derangedzebra/Binosaur-Barn/small-unrestrained/readme.md

# Binosaur Barn - Small and Unrestrained V1

This is the upgraded design that is installed at [Mori Point](https://goo.gl/maps/wpSysAgYLS7mhGZ39). It is meant to be attached to a thin metal pole using two pipe clamps. The binoculars inside are meant to be taken and returned, not restrained.

The design can be flipped horizontally if the position of the post needs to be swapped.

Version "b" is designed without the side mount, instead, it uses large pipe clamps for attachment to large fence posts or wire fencing.

### Parts

 * Hinge: https://smile.amazon.com/dp/B08MXQ23G7 (I think Home Depot also carries ones that will work)
 * Screws
   * 8x M3 thread 10mm long
   * 4x M3 thread nut (tooth-lock washer incorporated)
   * 4x #4 screws, either for sheet metal or wood
 * Pipe Clamps (number and size depends on model)

### Laser Cut Parts

 * Door: clear 1/4 inch thick acrylic, UV resistant preferred
 * Cover: clear 1/8 inch thick acrylic, UV resistant preferred

### 3D Print Notes

 * must be printed in PETG filament
 * designed for 0.8mm nozzle
 * holes for hinges may need to be drilled with 5/16 inch drill bit if too small
 * holes for back cover may need to be drilled with 1/8 inch drill bit if too small

### Laser Cutting Notes

 * there is an engraving layer with rasterized text
 * all holes must be tapped for M3 thread
