derangedzebra/Binosaur-Barn/large-leashed/binobarn-v2-infosheet.pdf

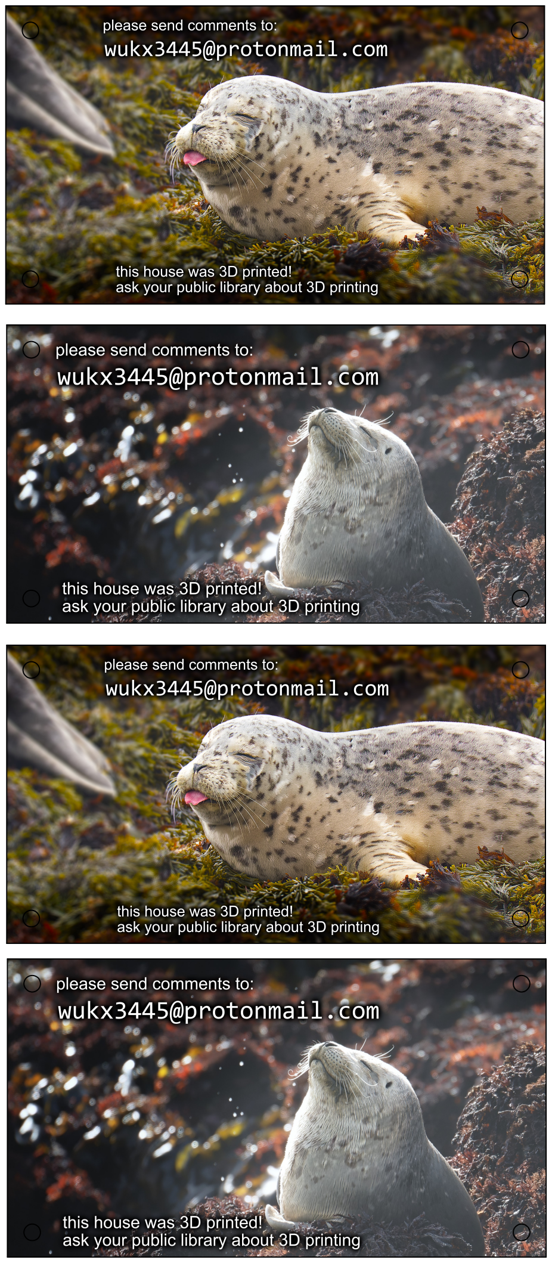
[picture p11: page 1]
