derangedzebra/Binosaur-Barn/photos/20221026_222111_1080.jpg

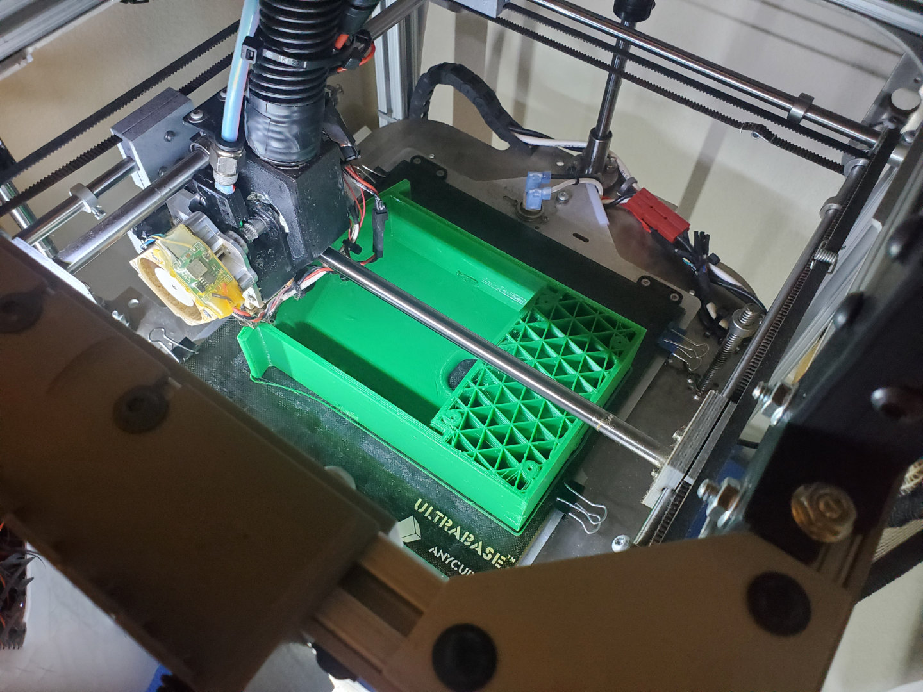
photos/20221026_222111_1080.jpg
