derangedzebra/Binosaur-Barn/photos/20221027_190804_1080.jpg

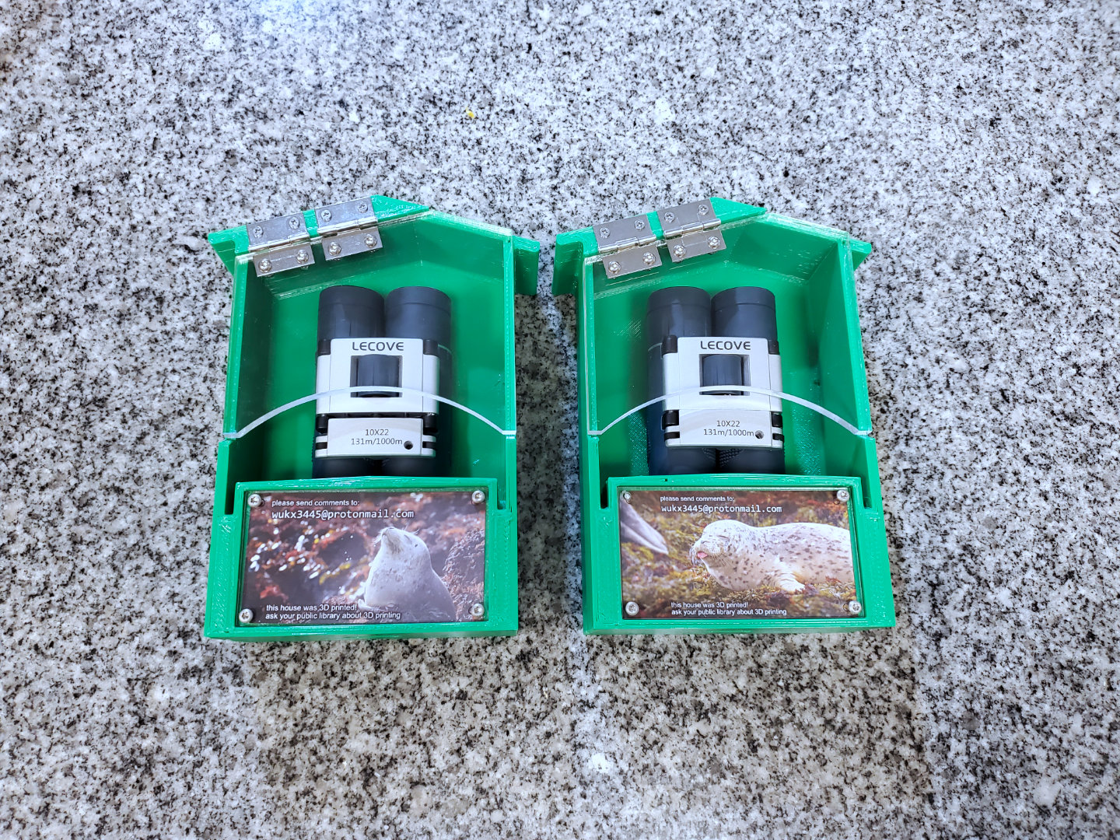
photos/20221027_190804_1080.jpg
