derangedzebra/Binosaur-Barn/photos/20221106_115400_1080.jpg

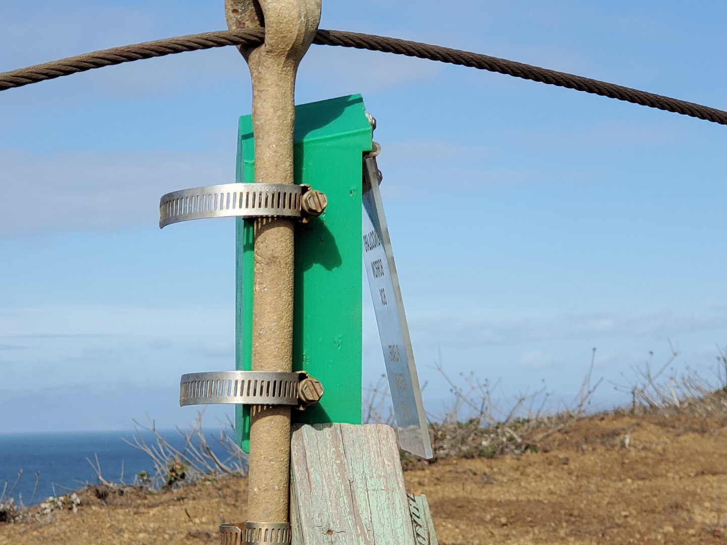
photos/20221106_115400_1080.jpg
