derangedzebra/Binosaur-Barn/photos/20221106_122157_1080.jpg

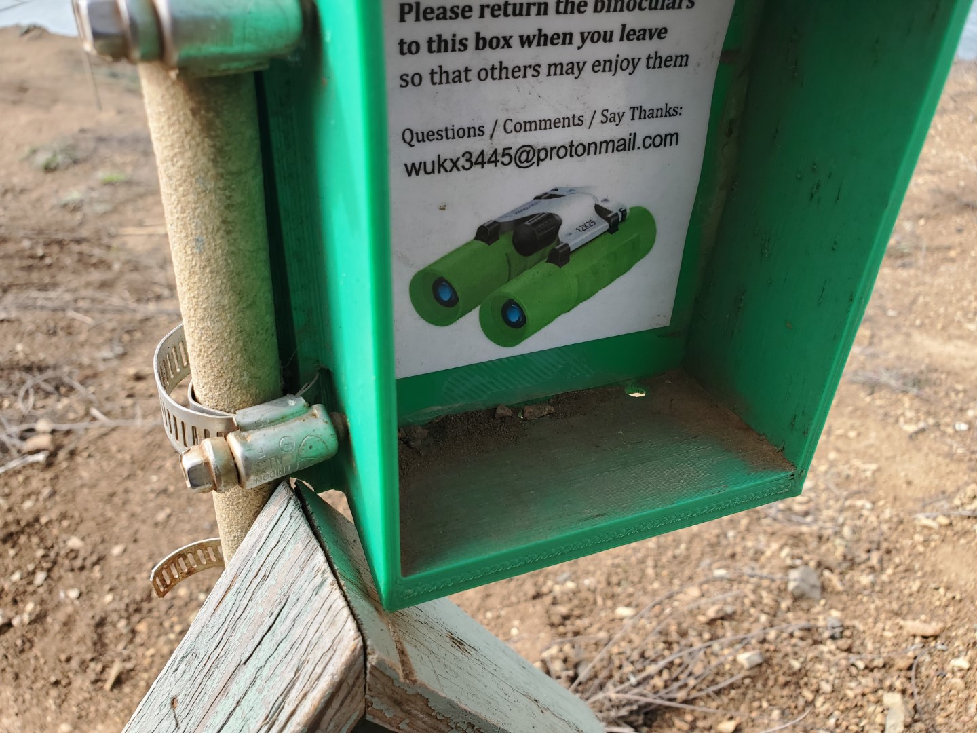
photos/20221106_122157_1080.jpg
