derangedzebra/Binosaur-Barn/large-leashed/binobarn-v2.STEP

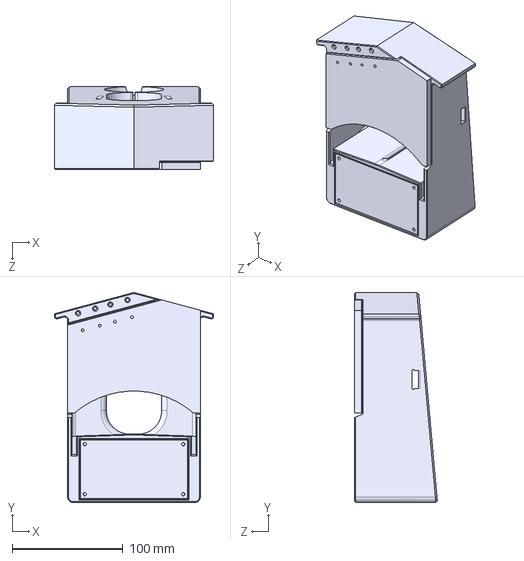
[picture p16: CAD file, 2022-11-06]
large-leashed/binobarn-v2.STEP
144.0 x 190.0 x 74.9 mm
