derangedzebra/Binosaur-Barn/small-unrestrained/binobarn-v1.STEP

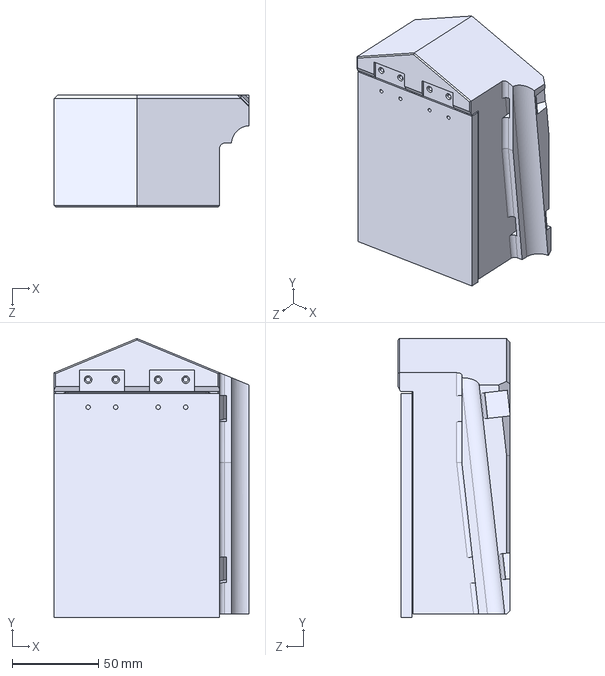
[picture p17: CAD file, 2022-11-06]
small-unrestrained/binobarn-v1.STEP
112.9 x 162.0 x 65.0 mm
