derangedzebra/Binosaur-Barn/small-unrestrained/binobarn-v1b.STEP

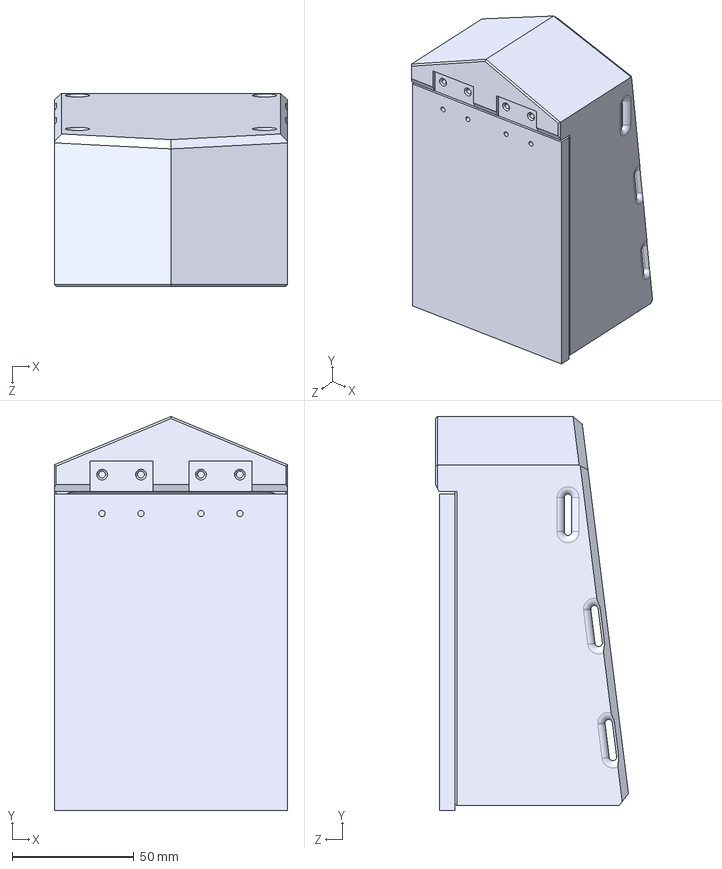
[picture p18: CAD file, 2022-10-29]
small-unrestrained/binobarn-v1b.STEP
96.0 x 162.0 x 79.4 mm
