derangedzebra/Binosaur-Barn/(list of files, cad)

Other CAD files:
large-leashed/binobarn-v2b.STEP
large-leashed/binobarn-v2.DXF
large-leashed/binobarn-v2.IGS
large-leashed/binobarn-v2.SLDDRW
large-leashed/binobarn-v2.SLDPRT
large-leashed/binobarn-v2.STL
large-leashed/binobarn-v2b.IGS
large-leashed/binobarn-v2b.SLDPRT
small-unrestrained/binobarn-v1.DXF
small-unrestrained/binobarn-v1.IGS
small-unrestrained/binobarn-v1.SLDDRW
small-unrestrained/binobarn-v1.SLDPRT
small-unrestrained/binobarn-v1.STL
small-unrestrained/binobarn-v1b.IGS
small-unrestrained/binobarn-v1b.SLDPRT
