derangedzebra/Binosaur-Barn/small-unrestrained/binobarn-v1-infosheet.pdf

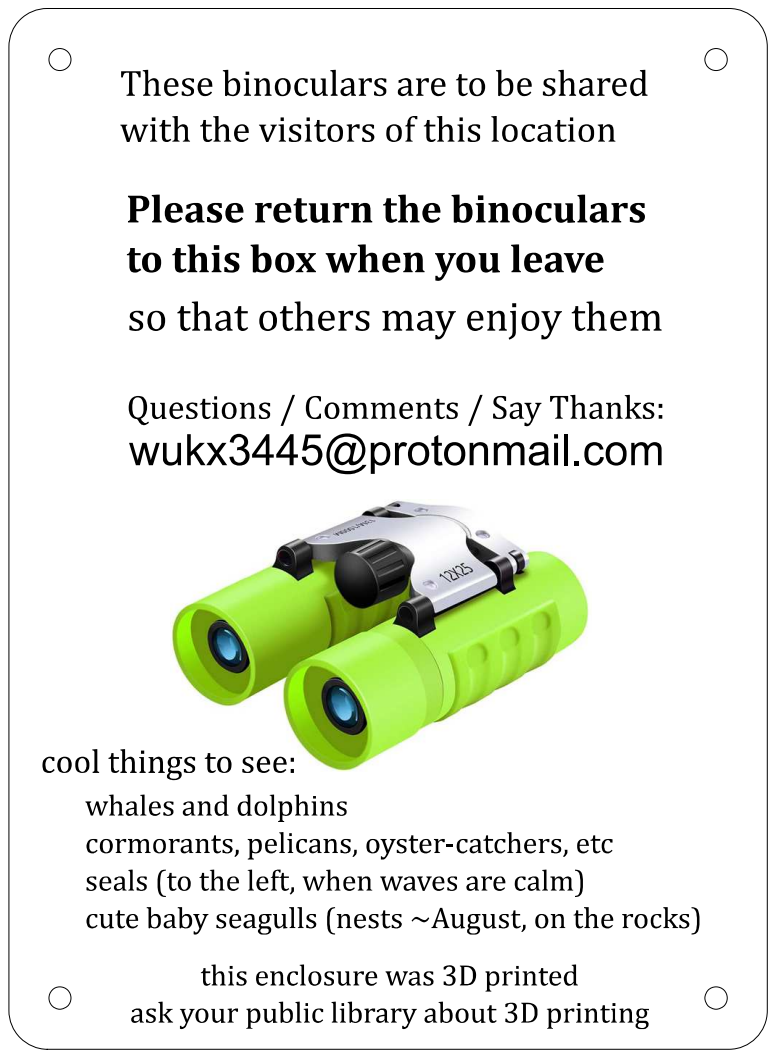
[picture p19: page 1]
