derangedzebra/Binosaur-Barn/(commit log)

2022-10-28 first upload
    [binobarn-v1.DXF, binobarn-v1.IGS, binobarn-v1.SLDDRW, binobarn-v1.SLDPRT, binobarn-v1.STEP, binobarn-v1.STL, binobarn-v2.DXF, binobarn-v2.IGS]
2022-10-28 renamed, added version B, doc updates
    [binobarn-v1.DXF, binobarn-v1.IGS, binobarn-v1.SLDDRW, binobarn-v1.SLDPRT, binobarn-v1.STEP, binobarn-v1.STL, binobarn-v1b.IGS, binobarn-v1b.SLDPRT]
2022-10-29 updated pipe clamp strap routing
    [binobarn-v1b.IGS, binobarn-v1b.SLDPRT, binobarn-v1b.STEP, binobarn-v2.IGS, binobarn-v2.SLDPRT, binobarn-v2.STEP, binobarn-v2.STL]
2022-11-06 wider strap path
    [binobarn-v2.IGS, binobarn-v2.SLDPRT, binobarn-v2.STEP, binobarn-v2.STL]
2022-11-06 widened strap, better strap angle
    [binobarn-v1.IGS, binobarn-v1.SLDPRT, binobarn-v1.STEP, binobarn-v1.STL]
2022-11-09 made cover 1mm smaller
